signaloid/C0-microSD-Hardware/rtl-examples/breathe-button/README.md

# Breathing example
This design alternatively pulses the red and green LEDs in a "breathing" motion. The design also supports changing the breathing speed using two pushbuttons connected as the diagram below shows:

### Build and flash the `breathe-button` design:
- Make sure that the open-source CAD toolchain is properly installed.
- Run `make`. 
- After the example builds successfully, insert the Signaloid C0-microSD into your computer.
- Verify the device path at which the Signaloid C0-microSD device shows up in your operating system. In our example, the Signaloid C0-microSD device path is `/dev/disk4`.
- Verify that the device is in `Bootloader` mode (solid red LED).
  - In case the device is not in `Bootloader` mode, you can switch its operation mode by running `make make flash DEVICE=<device-path>` and power-cycling the device.
- Run `make flash DEVICE=<device-path>`. Make sure to replace the `<device-path>` with the correct path of the C0-microSD. For example, if the device path is `/dev/disk4`, you will need to run `make flash DEVICE=/dev/disk4`.

Refer to the [documentation](https://c0-microsd-docs.signaloid.io/guides/identify-c0-microsd.html) to find the device path for the C0-microSD connected to your computer.

If the bitstream flashed successfully, you should see:
```console
sudo python3 ../../submodules/C0-microSD-utilities/C0_microSD_toolkit.py -t /dev/disk4 -b top.bin
Signaloid C0-microSD | Loaded configuration: Bootloader | Version: 1.0 | State IDLE
Filename:  top.bin
File size:  104090 bytes.
Flashing custom user bitstream...
Attempt 1 of 5: Flashing... Verifying...
Success: The data matches.
Done.
```

MicroSD to SD card adapters often have a small switch on the side, check that the switch is in the position that allows writing to the C0-microSD.
If the switch is not in the correct position, you will encounter a permission error when attempting to flash the bitstream. 

You can now unplug the C0-microSD from your computer and power it up using a microSD breakout board. After 3 seconds, you should see the red and green LEDs breathing alternatively.

### Schematic
```
                 VCC                         
┌────────────┐  ──┬──                        
│C0-microSD  │    │                          
│            │    │                          
│         3v3│────┘                          
│         GND├───────┐                       
│     SD_DAT2│───────┼───────────┐           
│     SD_DAT3├───────┼───────────┼───────┐   
└────────────┘       │           │       │   
                     │            /       /  
                   ──┴──         /       /   
                    GND          │       │   
                               ──┴──   ──┴── 
                                GND     GND  
```

### Breadboard configuration example
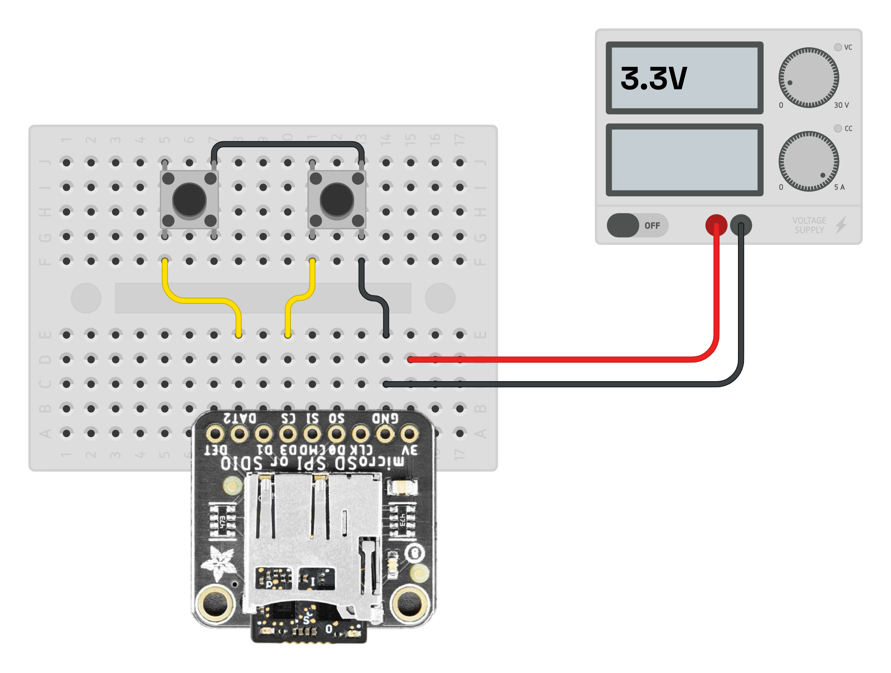
[picture p1: rtl-examples/breathe-button/images/breathe-button-breadboard.png]
Breathe button breadboard schematic


If the bitstream flashed successfully, you should see:
```console
sudo python3 ../../submodules/C0-microSD-utilities/C0_microSD_toolkit.py -t /dev/disk4 -b top.bin
Signaloid C0-microSD | Loaded configuration: Bootloader | Version: 1.0 | State IDLE
Filename:  top.bin
File size:  104090 bytes.
Flashing custom user bitstream...
Attempt 1 of 5: Flashing... Verifying...
Success: The data matches.
Done.
```

You can now unplug the C0-microSD from your computer and power it up using a microSD breakout board. After 3 seconds, you should see the red and green LEDs blinking alternatively.
