signaloid/C0-microSD-Hardware/c0-microsd-quickstart.pdf

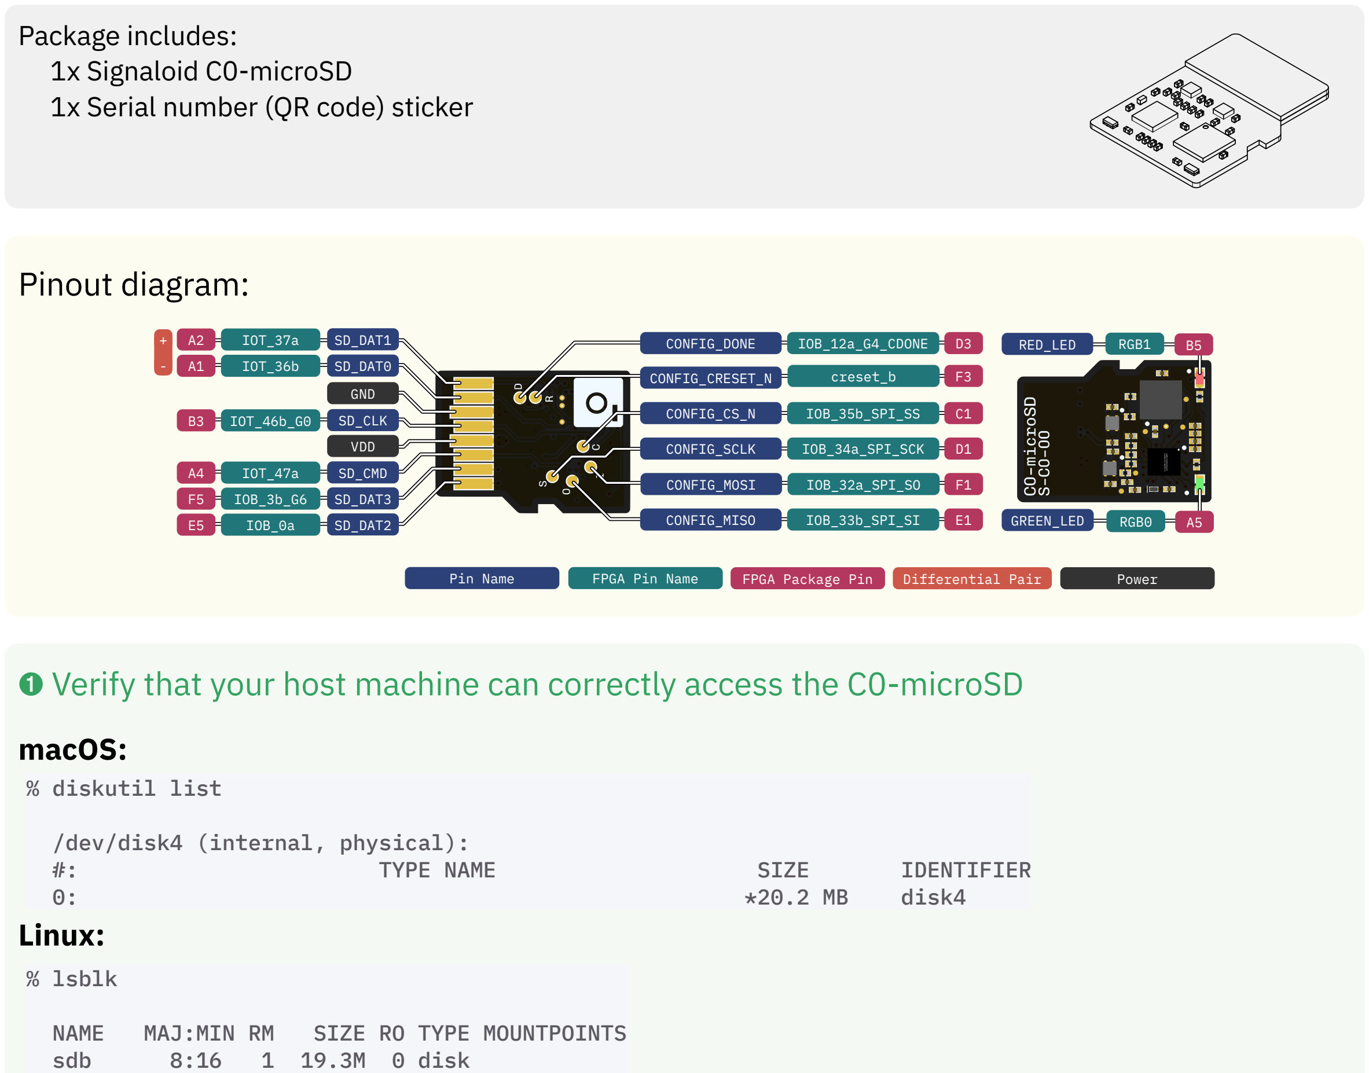
[picture p8: figure]
% diskutil list; /dev/disk4 (internal, physical):; TYPE NAME; SIZE; IDENTIFIER; disk4; % lsblk; sdb; 1 19.3M 0 disk; macOS:; Linux:; Package includes: 1x Signaloid C0-microSD 1x Serial number (QR code) sticker; CONFIG_DONE; CONFIG_CRESET_N; CONFIG_MOSI; CONFIG_SCLK; CONFIG_CS_N; CONFIG_MISO; VDD; GND; SD_CMD SD_DAT3 SD_DAT2; SD_CLK; SD_DAT0; SD_DAT1; RED_LED; GREEN_LED; IOB_12a_G4_CDONE; IOB_32a_SPI_SO; IOB_34a_SPI_SCK; IOB_35b_SPI_SS; IOB_33b_SPI_SI; IOT_47a IOB_3b_G6 IOB_0a; IOT_46b_G0; IOT_36b; IOT_37a; creset_b; RGB1; RGB0; Pin Name; FPGA Pin Name; FPGA Package Pin; Differential Pair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

# ➊ Verify that your host machine can correctly access the C0-microSD

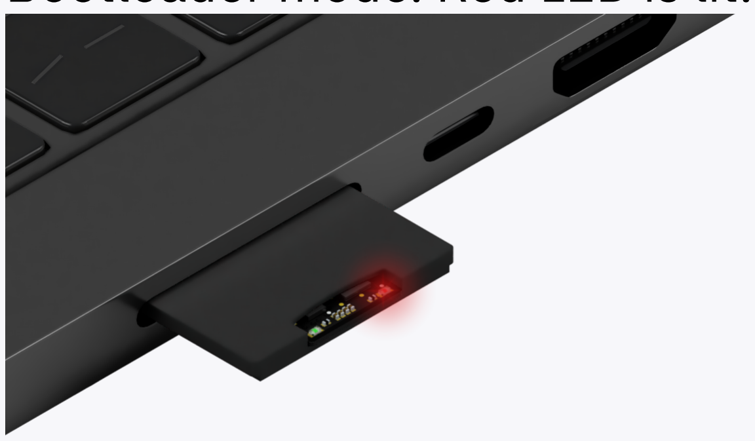
[picture p9: figure]

➌ Run an example.

NAME | MAJ:MIN RM | SIZE RO TYPE MOUNTPOINTS

# ➋ Check which mode the C0-microSD is in (default is “bootloader mode”)

Bootloader mode. Red LED is lit. | SoC mode. Green LED is lit.

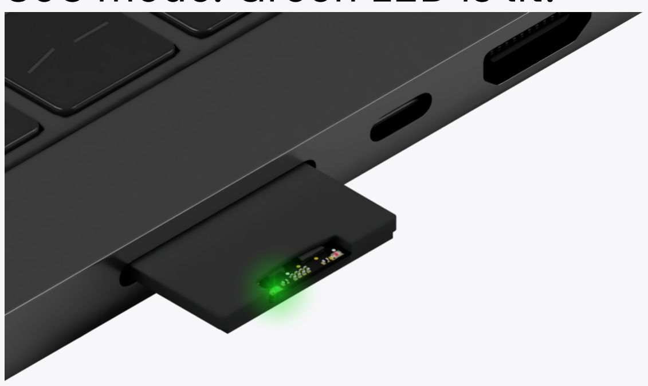
[picture p10: figure]

# In bootloader mode, you can load custom FPGA bitstreams to the

C0-microSD. See link for hardware RTL examples.

# In SoC mode, you can load programs to the Signaloid RISC-V SoC and

interact with these programs over the SD interface. See links for examples.

# Signaloid C0-microSD QuickStart Guide

Copyright © 2025 Signaloid.
