signaloid/C0-microSD-Hardware/docs/hardware-overview/compatibility.md

---
layout: default
parent: "Hardware Overview"
title: "Compatibility"
nav_order: 6
---

# Device compatibility

We designed the Signaloid C0-microSD to emulate a version 1.0 SD card. We have tested the compatibility with the following host devices:

| Host device | Product Page | Mechanical | SD Interface |
| :--- | :---: | :---: | :---: |
| Macbook Pro M1 | [apple.com](https://support.apple.com/en-us/111902) | Yes | Yes |
| SD-Dev | [crowdsupply.com](https://www.crowdsupply.com/signaloid/signaloid-c0-microsd) | Yes | Yes |
| Kingston MobileLite Plus | [kingston.com](https://www.kingston.com/en/memory-card-readers/mobilelite-plus-sd-reader) | Yes | Yes |
| Hoco HB20 | [hocotech.com](https://hocotech.com/product/mobile-accessories/cables/adapters/card-reader-hb20-mindful-2-in-1-usb2-0-usb3-0/) | Yes | Yes |
| Hama "8in1" Transparent | [hama.com](https://ae.hama.com/00091092/hama-8in1-usb-2-0-card-reader-sd-microsd-transparent) | Yes | Yes |
| Ugreen USB C 7in1 Hub | [ugreen.com](https://eu.ugreen.com/products/ugreen-usb-c-7-in-1-hub-with-4k-60hz-hdmi?variant=46973588078940) | Yes | Yes |
| UGREEN Micro SD Card Reader | [ugreen.com](https://eu.ugreen.com/products/50706?_pos=5&_sid=f76931dfa&_ss=r) | Yes | Yes |
| CrowdSupply microSD Card Reader | [crowdsupply.com](https://www.crowdsupply.com/crowd-supply/basics) | Yes | Yes |
| Sandisk Pro Reader | [sandisk.com](https://shop.sandisk.com/products/accessories/memory-card-readers/sandisk-professional-pro-reader-sd-microsd?sku=SDPR5A8-0000-GBAND) | Yes | Yes |
| Delock CFadapter | [delock.com](https://www.delock.com/produkt/62542/merkmale.html) | Yes | Yes |

We have also tested the compatibility of the Signaloid C0-microSD with multiple existing embedded platforms that support microSD cards:

| Host device | Product Page | Mechanical | SD Interface |
| :--- | :---: | :---: | :---: |
| Bosch ctrlX core X3 PLC | [boschrexroth.com](https://apps.boschrexroth.com/microsites/ctrlx-automation/en/portfolio/ctrlx-core/) | Yes | Yes |
| Wago PFC100 PLC |  [wago.com](https://www.wago.com/global/plcs-%E2%80%93-controllers/compact-controller-100/p/751-9301)  | Yes | Yes |
| Wago PFC200 PLC | [wago.com](https://www.wago.com/global/automation-technology/discover-plcs/pfc200) | Yes | Untested |
| Phoenix Contact PLCNEXT PLC | [phoenixcontact.com](https://www.phoenixcontact.com/en-us/us-lp-open) | Yes | Untested |
| SparkFun MicroMod AssetTracker | [sparkfun.com](https://www.sparkfun.com/products/17272) | Yes | Untested |
| SparkFun MicroMod-MachineLearning Carrier Board | [sparkfun.com](https://www.sparkfun.com/products/16400) | Yes | Untested |
| SparkFun DataLogger IoT | [sparkfun.com](https://www.sparkfun.com/products/20594) | Yes | Untested |
| SparkFun QWIIC OpenLog | [sparkfun.com](https://www.sparkfun.com/products/15164) | Yes | Untested |
| SparkFun ThingPlus RP2040 | [sparkfun.com](https://www.sparkfun.com/products/17745) | Yes | Untested |
| SparkFun ThingPlus STM32 | [sparkfun.com](https://www.sparkfun.com/products/17712) | Yes | Yes |
| SparkFun OpenLog Artemis | [sparkfun.com](https://www.sparkfun.com/products/16832) | Yes | Untested |
| Adafruit Feather Adalogger | [adafruit.com](https://www.adafruit.com/product/2796) | Yes | Untested |
| Adafruit Feather M0 Adalogger | [adafruit.com](https://www.adafruit.com/product/2796) | Yes | Untested |
| Beaglebone AI | [beagleboard.org](https://www.beagleboard.org/boards/beaglebone-ai) | Yes | Untested |
| M5Stack Cardputer | [m5stack.com](https://shop.m5stack.com/products/m5stack-cardputer-kit-w-m5stamps3) | Yes | Yes |
