signaloid/C0-microSD-Hardware/docs/assets/images/C0-microSD-front-back.jpeg

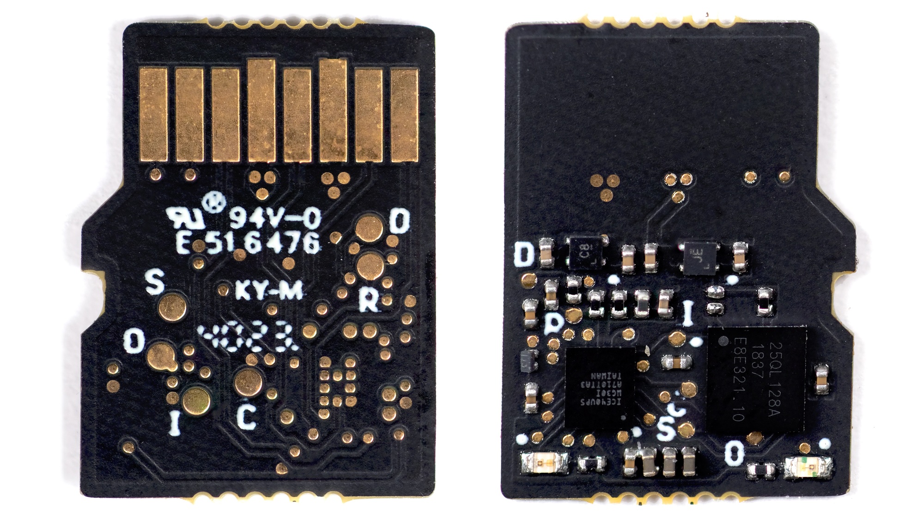
docs/assets/images/C0-microSD-front-back.jpeg
