signaloid/C0-microSD-Hardware/docs/assets/images/C0-microSD-pinout-horizontal.png

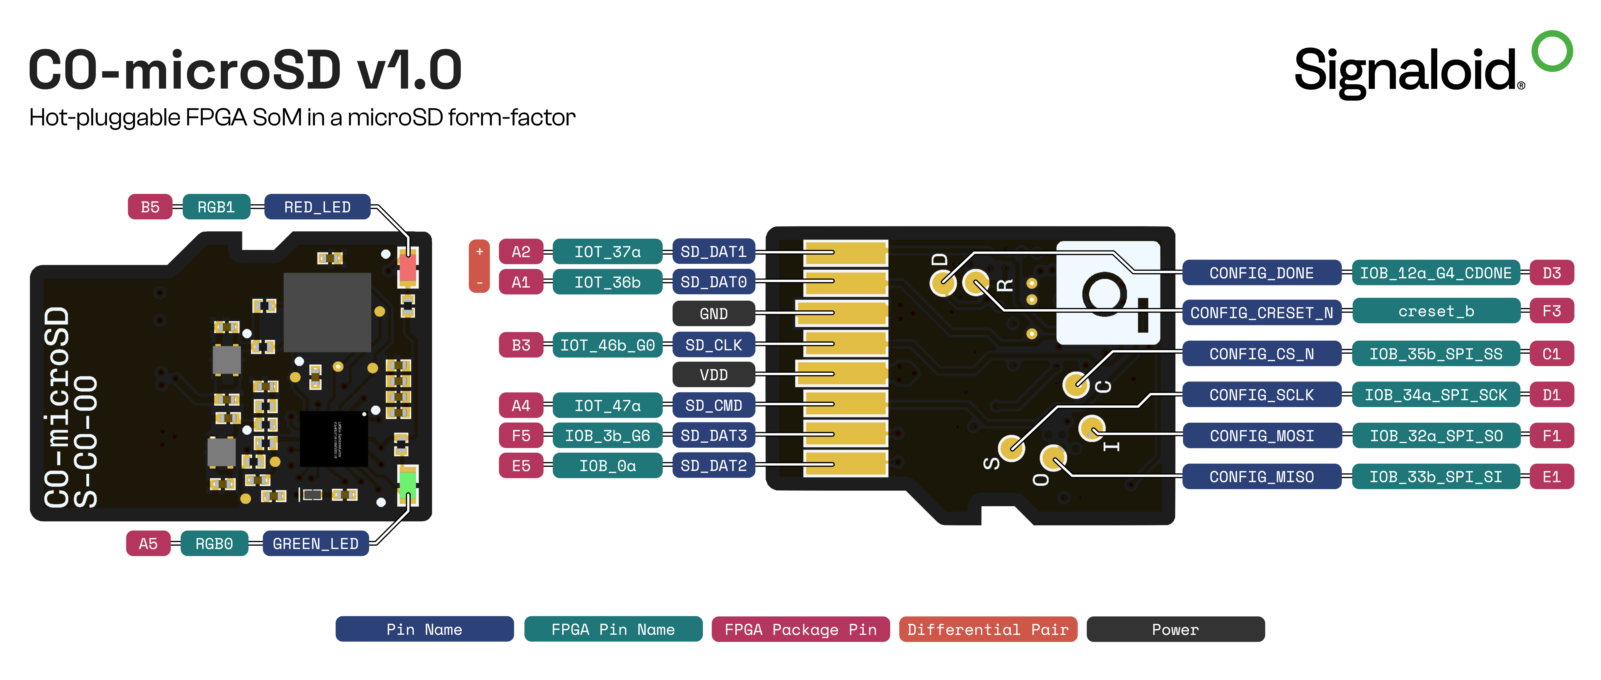
docs/assets/images/C0-microSD-pinout-horizontal.png
