signaloid/C0-microSD-Hardware/docs/assets/images/C0-microSD-pinout.png

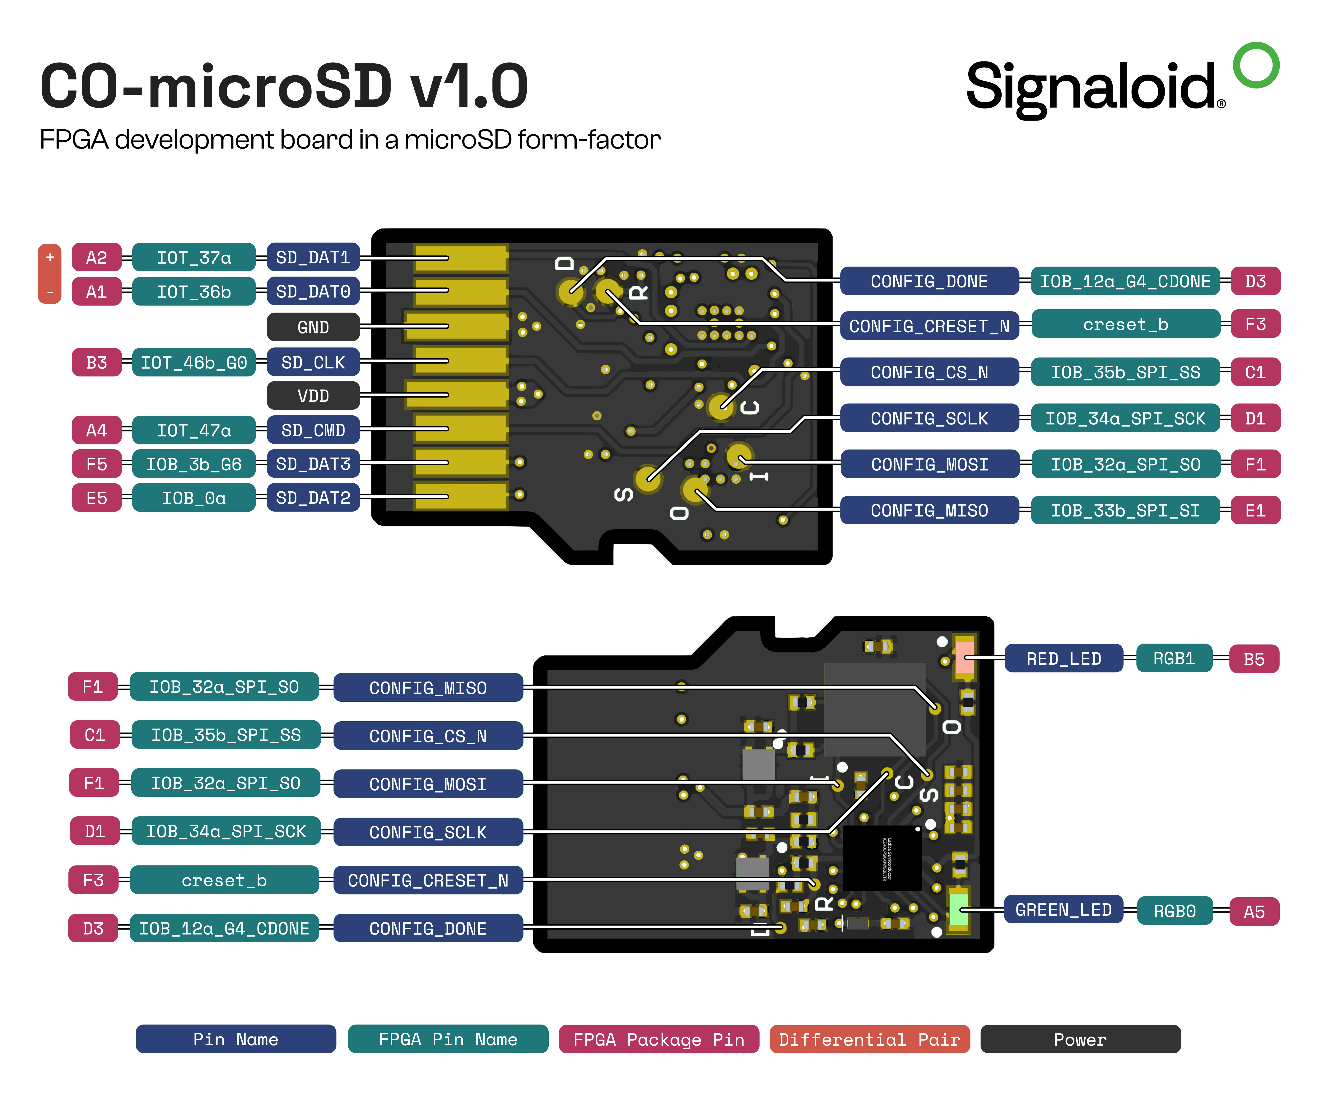
docs/assets/images/C0-microSD-pinout.png
