signaloid/C0-microSD-Hardware/docs/assets/images/diagrams/bootloader-logic-diagram.png

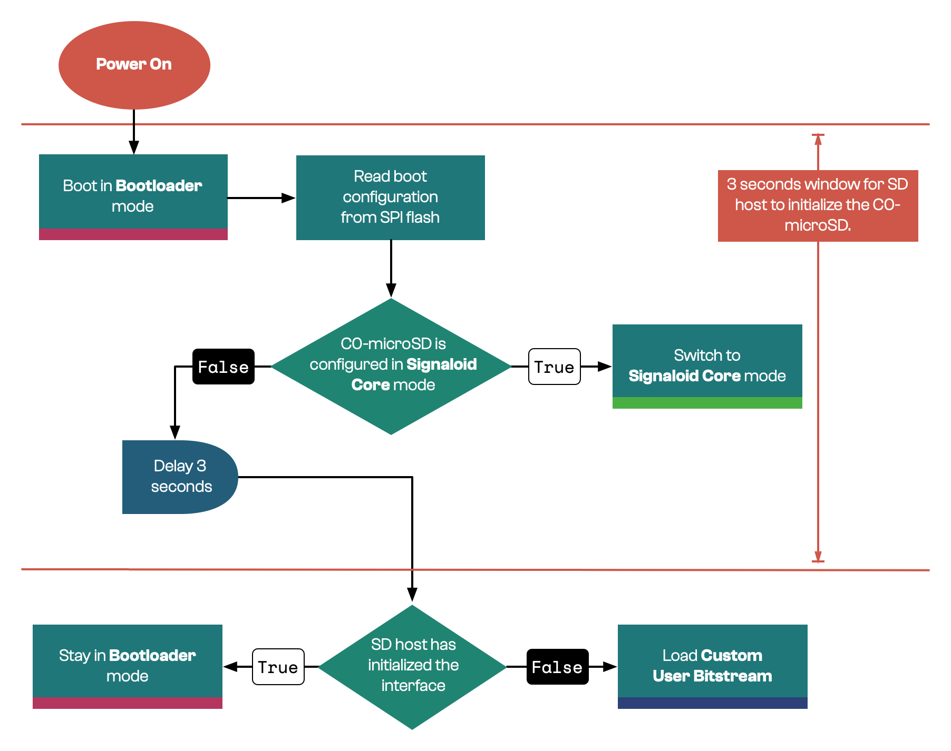
docs/assets/images/diagrams/bootloader-logic-diagram.png
