signaloid/C0-microSD-Hardware/docs/assets/images/diagrams/C0-microSD-memory-map.png

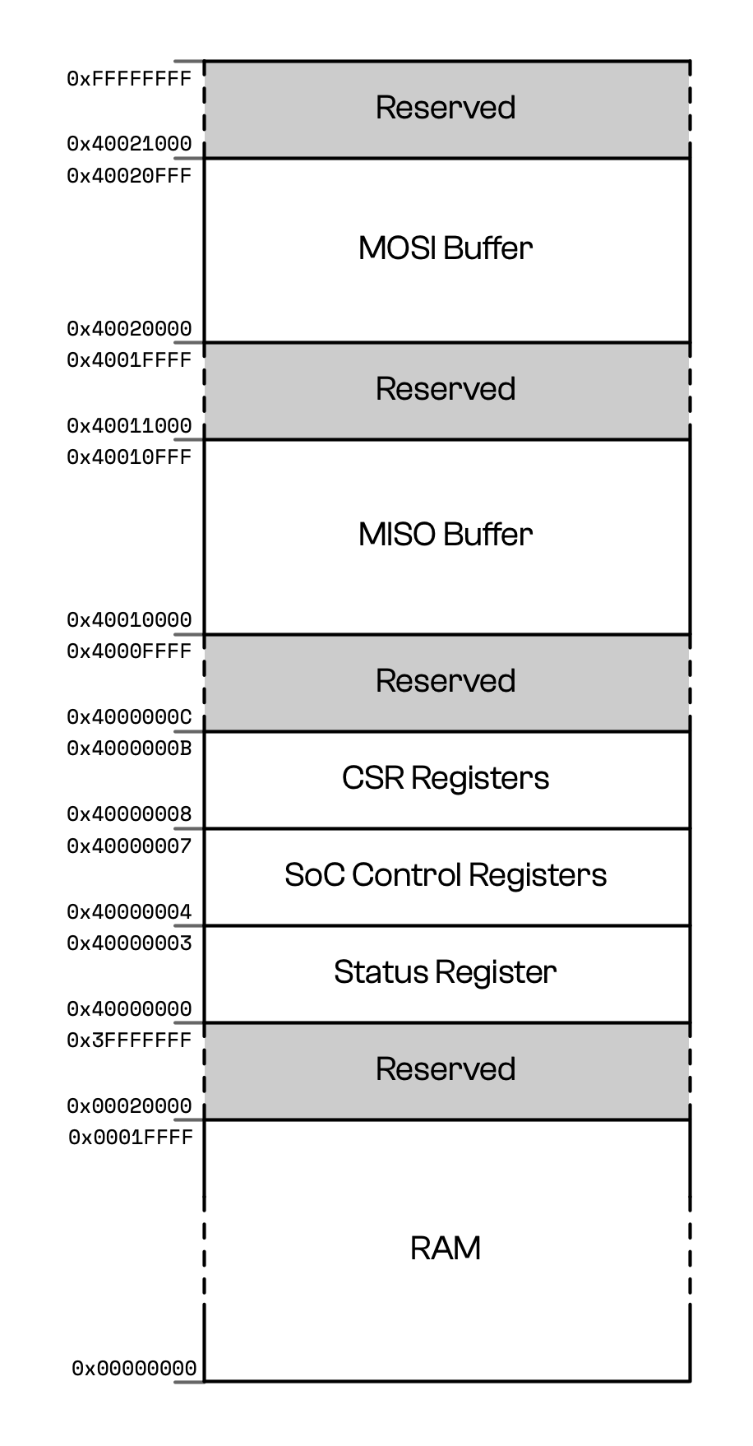
docs/assets/images/diagrams/C0-microSD-memory-map.png
