signaloid/C0-microSD-Hardware/docs/assets/images/diagrams/C0-uSD-tigard-connection.png

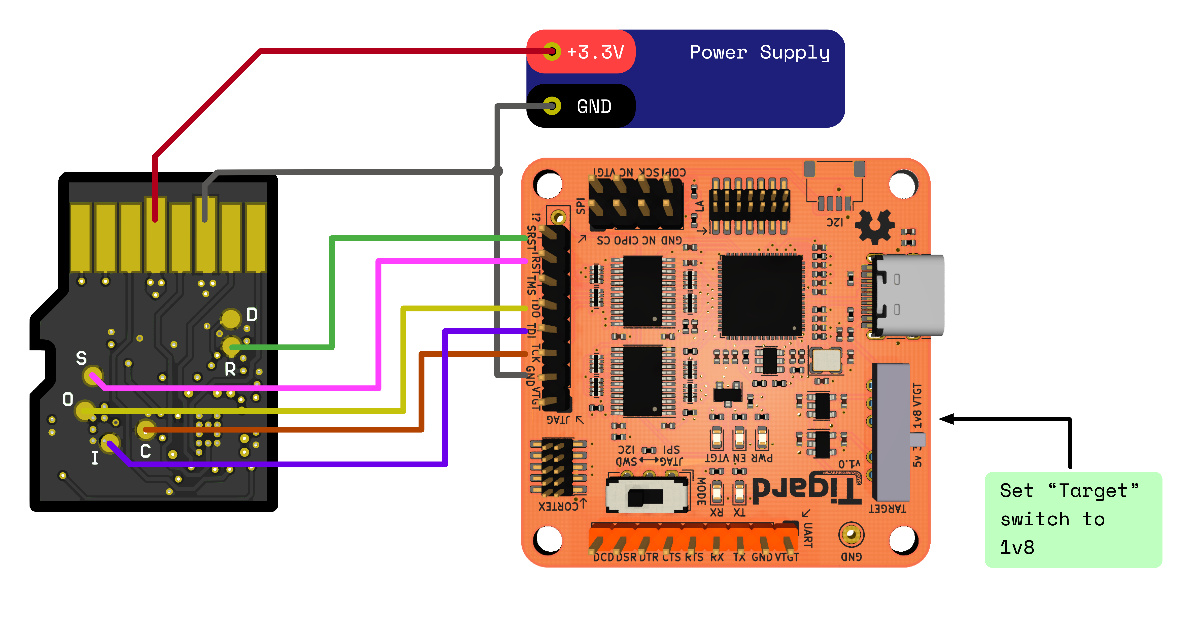
docs/assets/images/diagrams/C0-uSD-tigard-connection.png
