signaloid/C0-microSD-Hardware/docs/assets/images/mac-popup.png

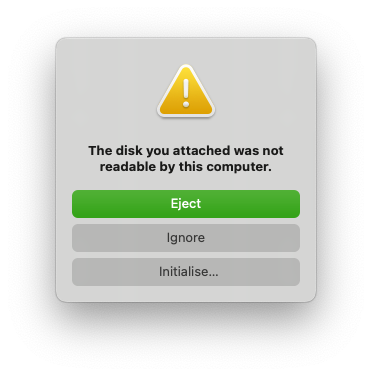
docs/assets/images/mac-popup.png
