signaloid/C0-microSD-Hardware/docs/assets/images/macbook-animations/insert.gif

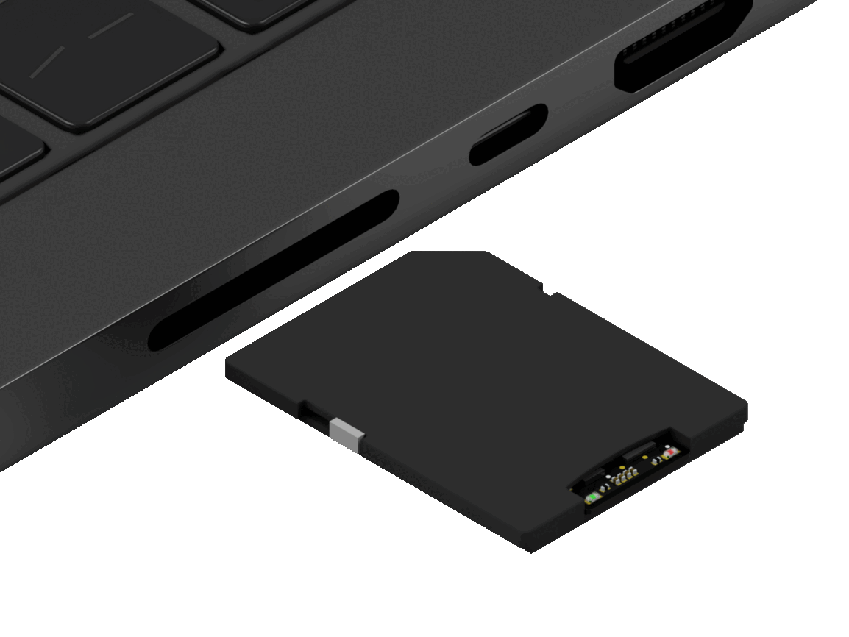
docs/assets/images/macbook-animations/insert.gif
