signaloid/C0-microSD-Hardware/docs/assets/images/ortho-renders/breakout-board/breakout-board.png

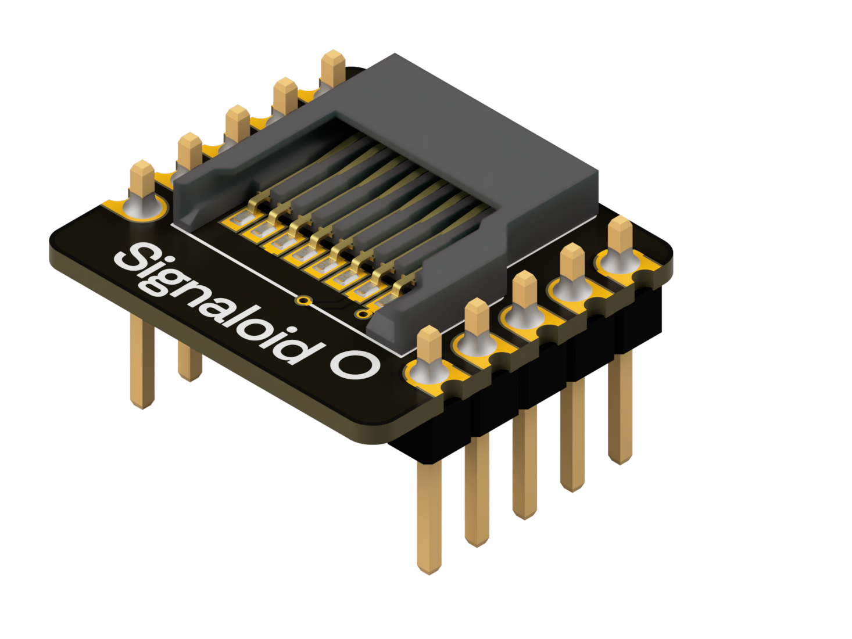
docs/assets/images/ortho-renders/breakout-board/breakout-board.png
