signaloid/C0-microSD-Hardware/docs/assets/images/ortho-renders/C0-microSD-signaloid-core/C0-microSD-with-signaloid-core-green-led.png

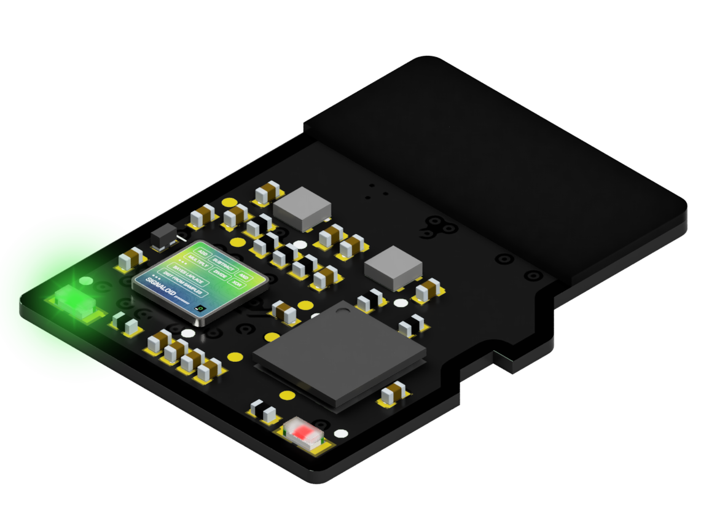
docs/assets/images/ortho-renders/C0-microSD-signaloid-core/C0-microSD-with-signaloid-core-green-led.png
