signaloid/C0-microSD-Hardware/docs/assets/images/ortho-renders/normal_size/C0-uSD-ortho-render-bot.png

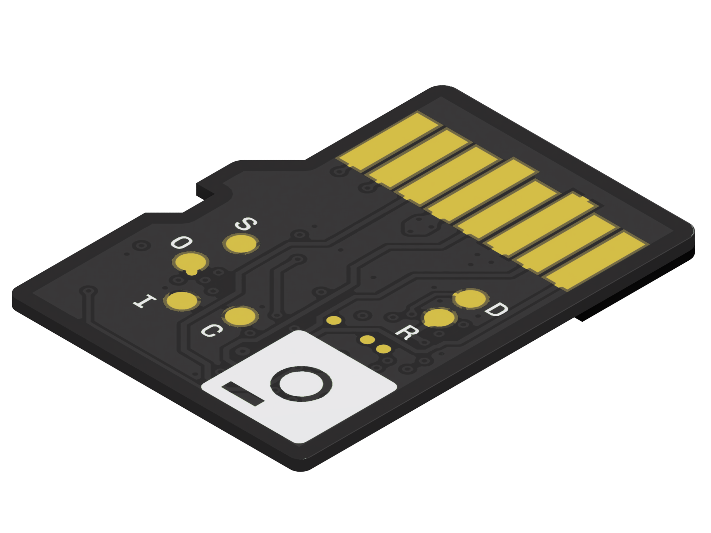
docs/assets/images/ortho-renders/normal_size/C0-uSD-ortho-render-bot.png
