signaloid/C0-microSD-Hardware/docs/assets/images/sd-dev-pinout.jpg

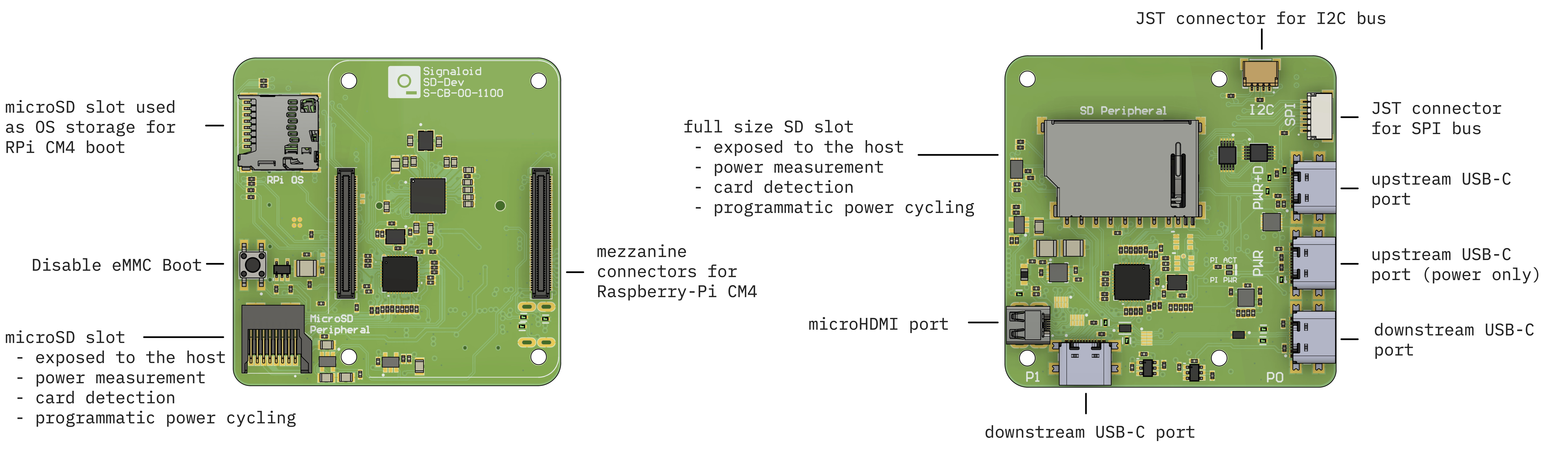
docs/assets/images/sd-dev-pinout.jpg
