signaloid/C0-microSD-Hardware/docs/assets/images/signaloid-module-scale-01.jpeg

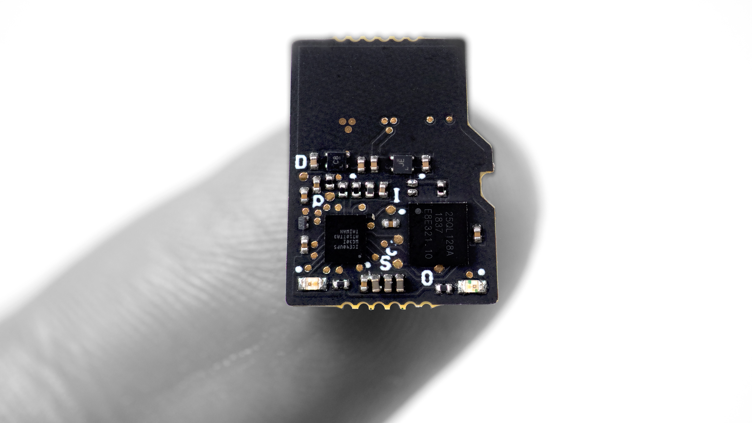
docs/assets/images/signaloid-module-scale-01.jpeg
