signaloid/C0-microSD-Hardware/docs/assets/images/subsea-integration.png

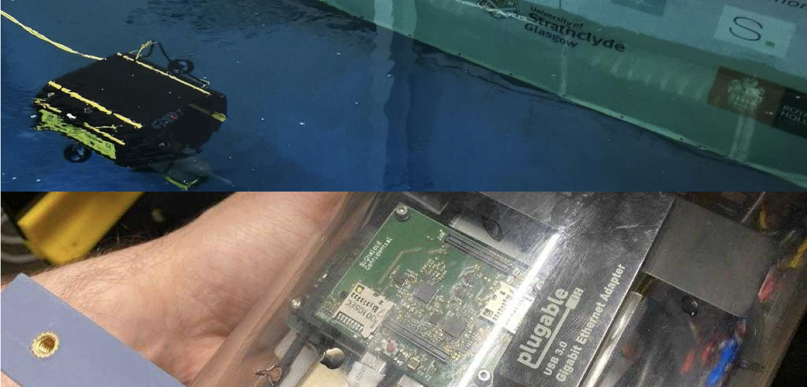
docs/assets/images/subsea-integration.png
