signaloid/C0-microSD-Hardware/images/C0-microSD-block-diagram.png

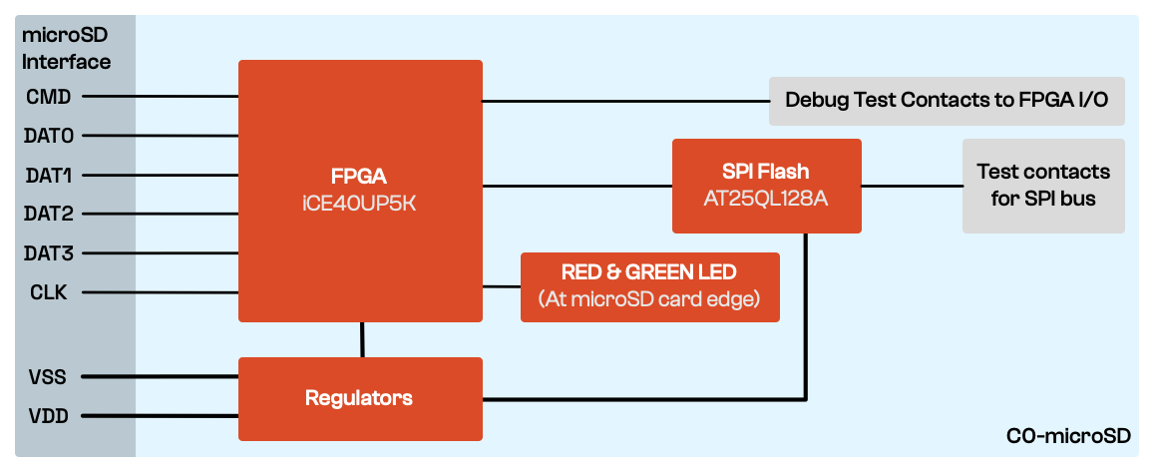
images/C0-microSD-block-diagram.png
