signaloid/C0-microSD-Hardware/rtl-examples/blink/images/mac-popup.png

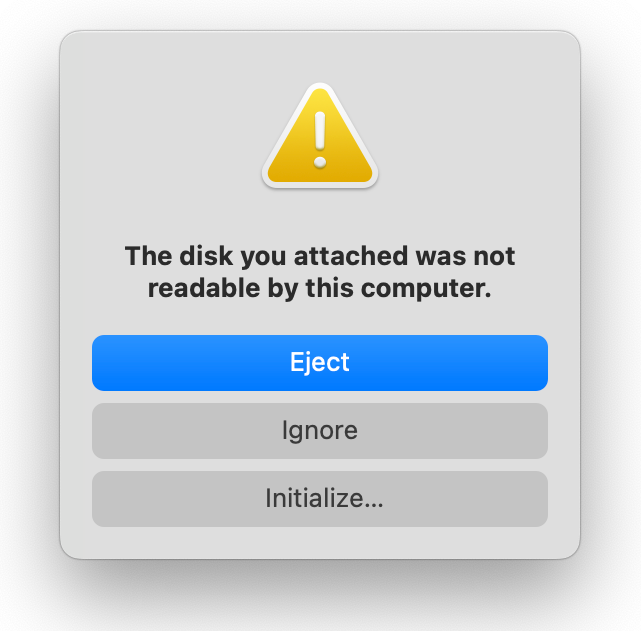
rtl-examples/blink/images/mac-popup.png
