signaloid/C0-microSD-Hardware/docs/guides/index.md

---
layout: default
title: "Guides"
has_children: true
nav_order: 3
---

# C0-microSD Guides
In this section of the documentation you can find a series of guides for working with your C0-microSD.
