signaloid/C0-microSD-Hardware/hardware/schematic.pdf

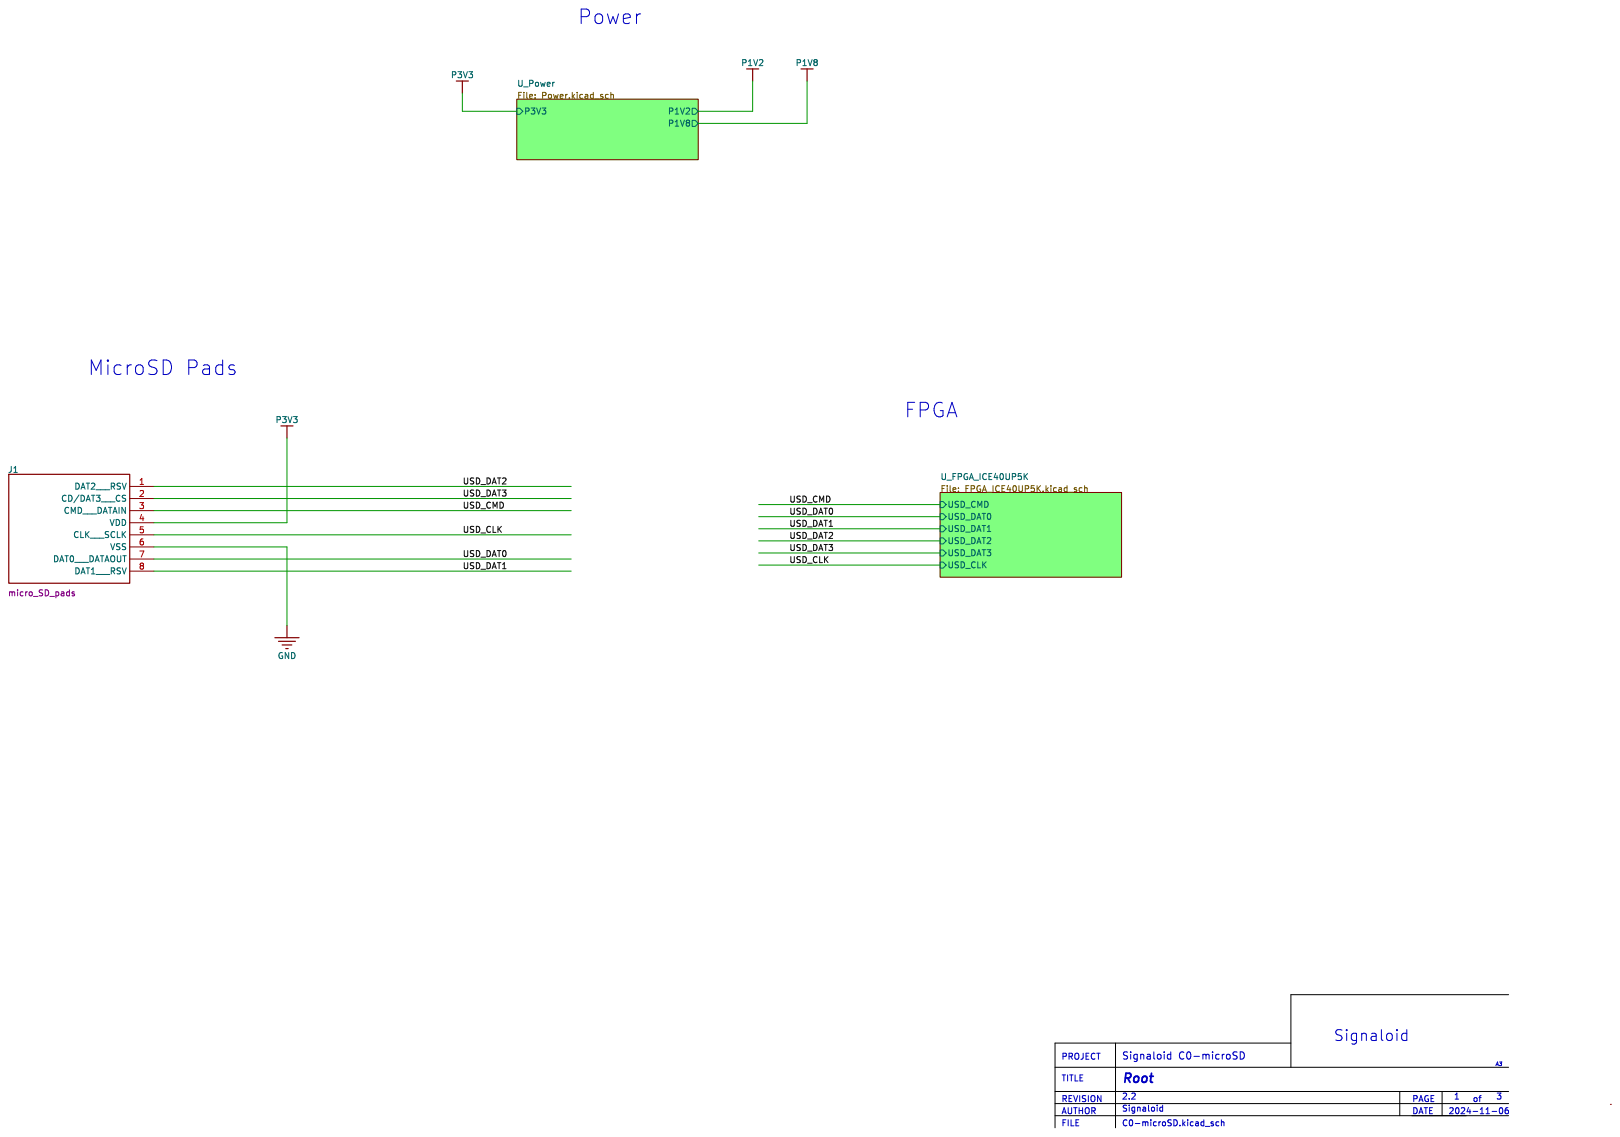
[picture p37: page 1]

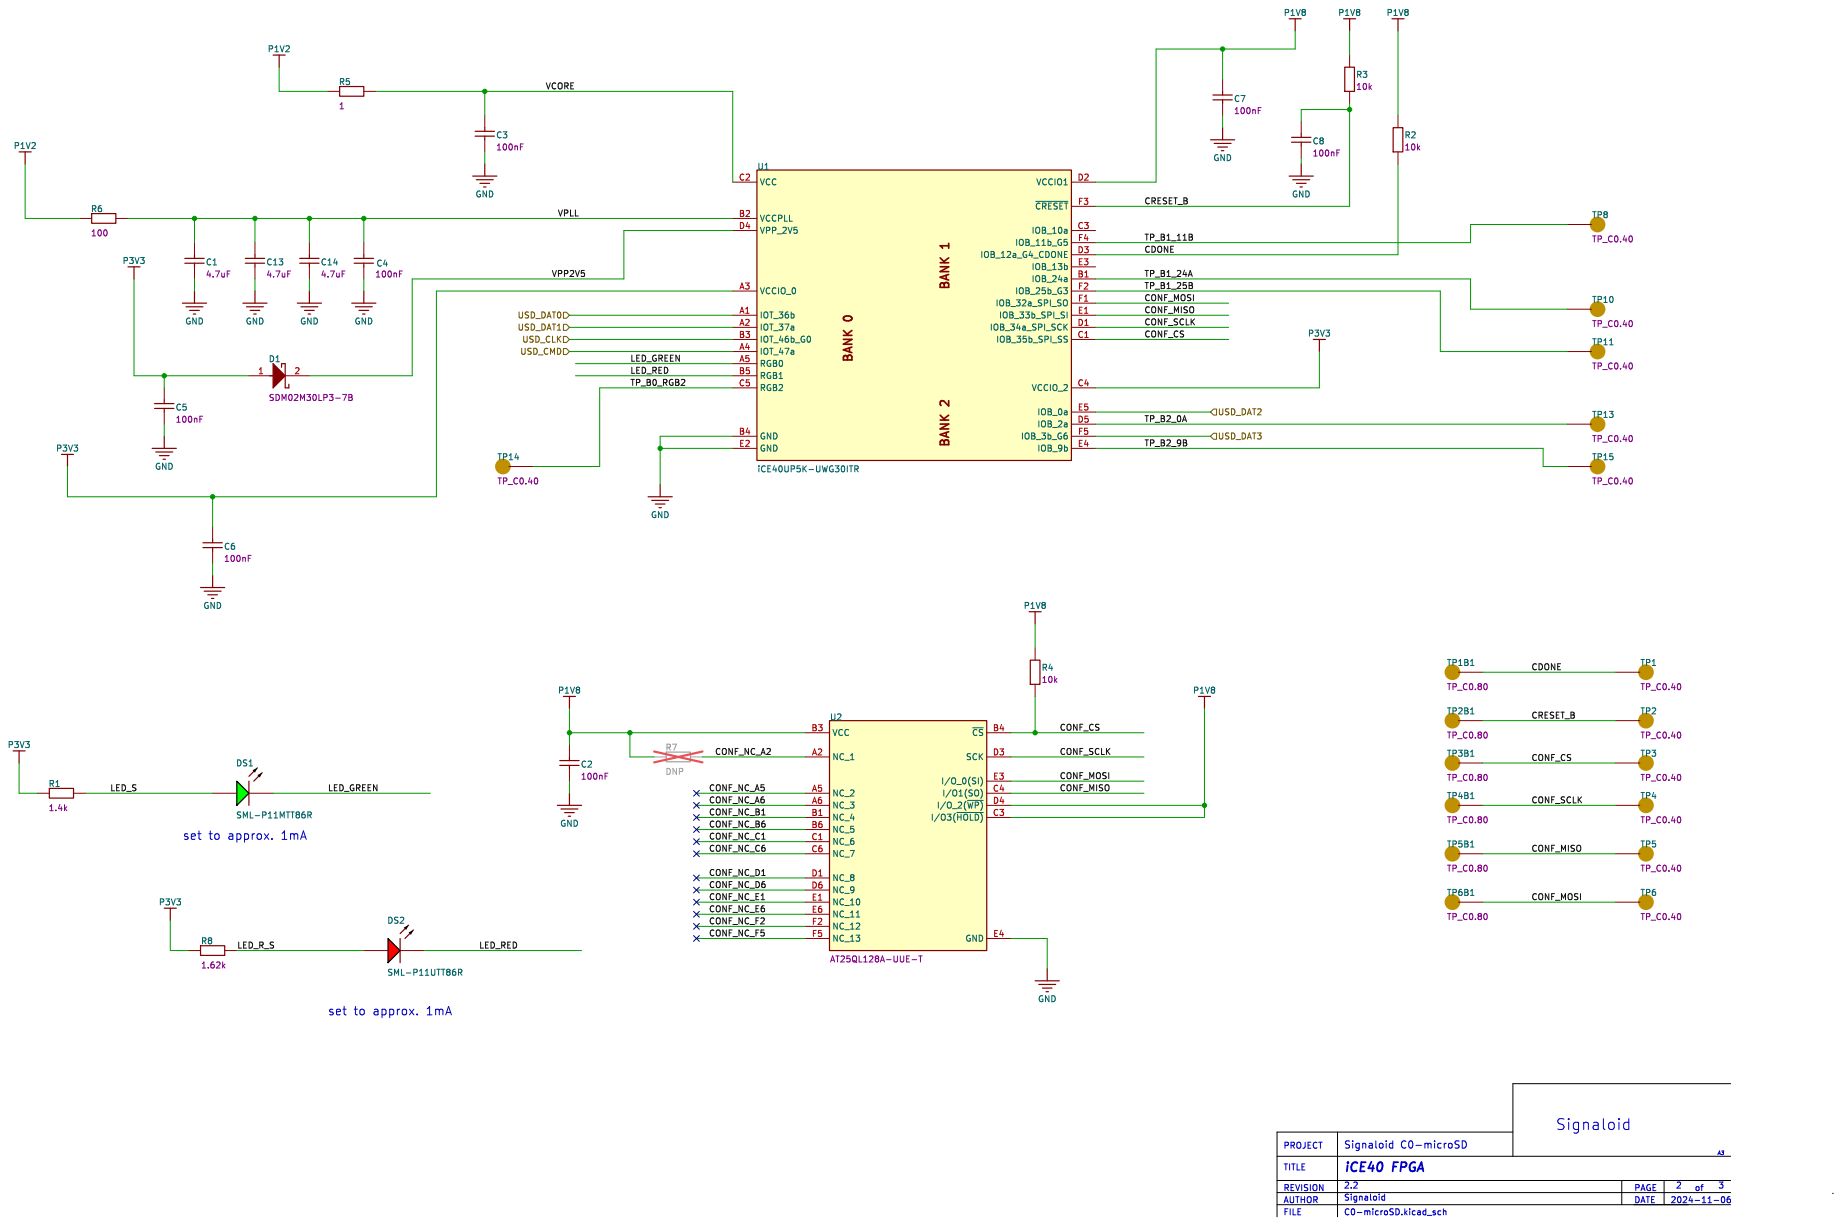
[picture p38: page 2]

FILE set to approx. 1mA

of set to approx. 1mA

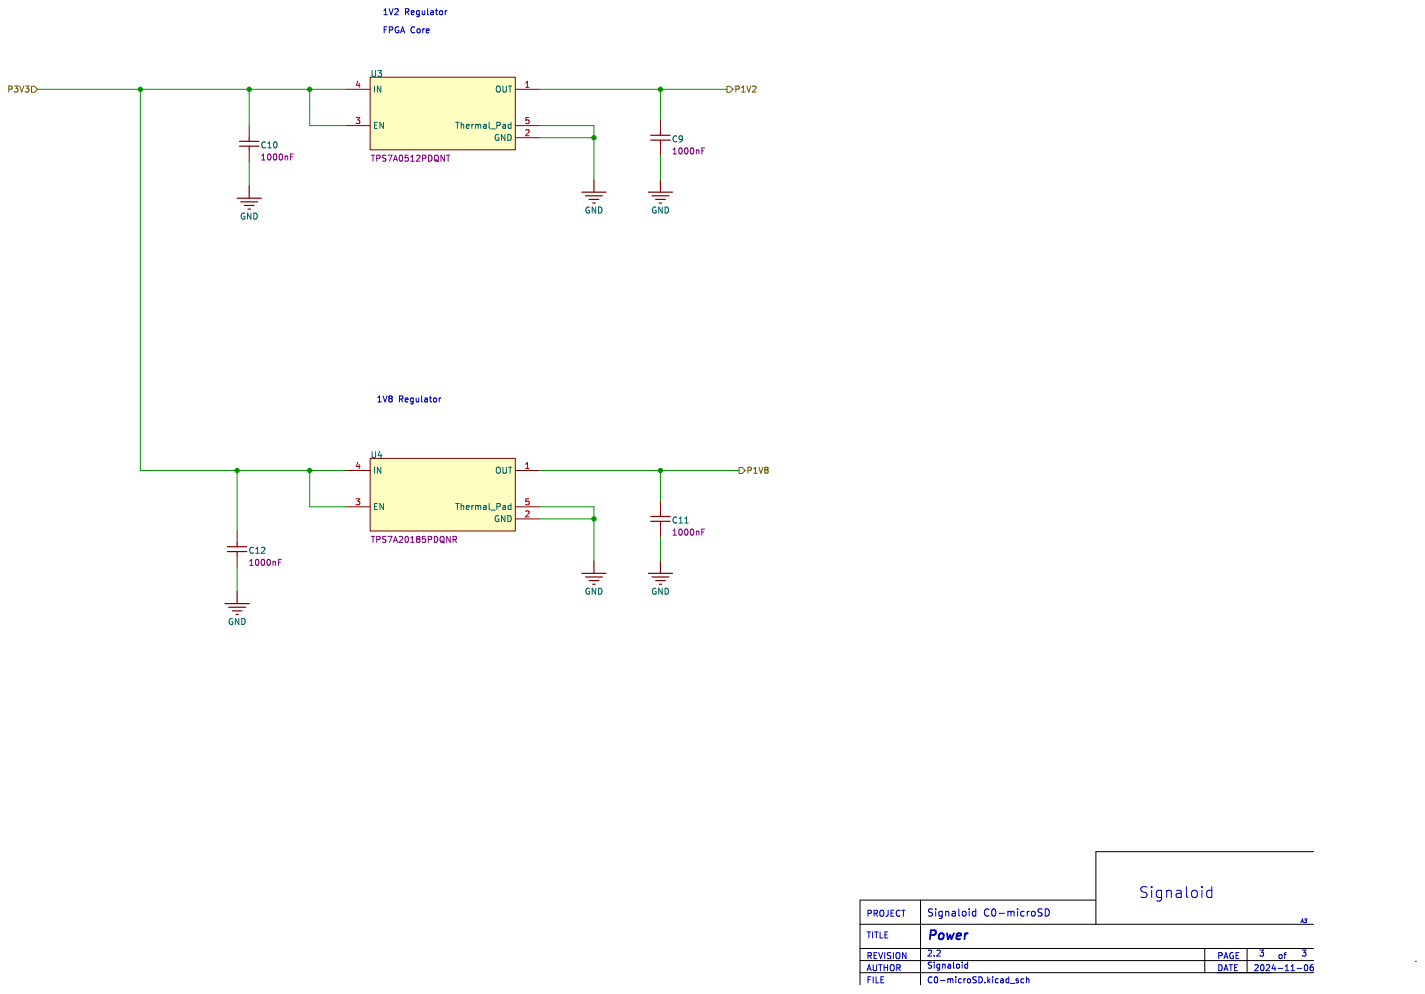
[picture p39: page 3]
