signaloid/C0-microSD-Hardware/docs/assets/images/diagrams/bootloader-logic-diagram.pdf

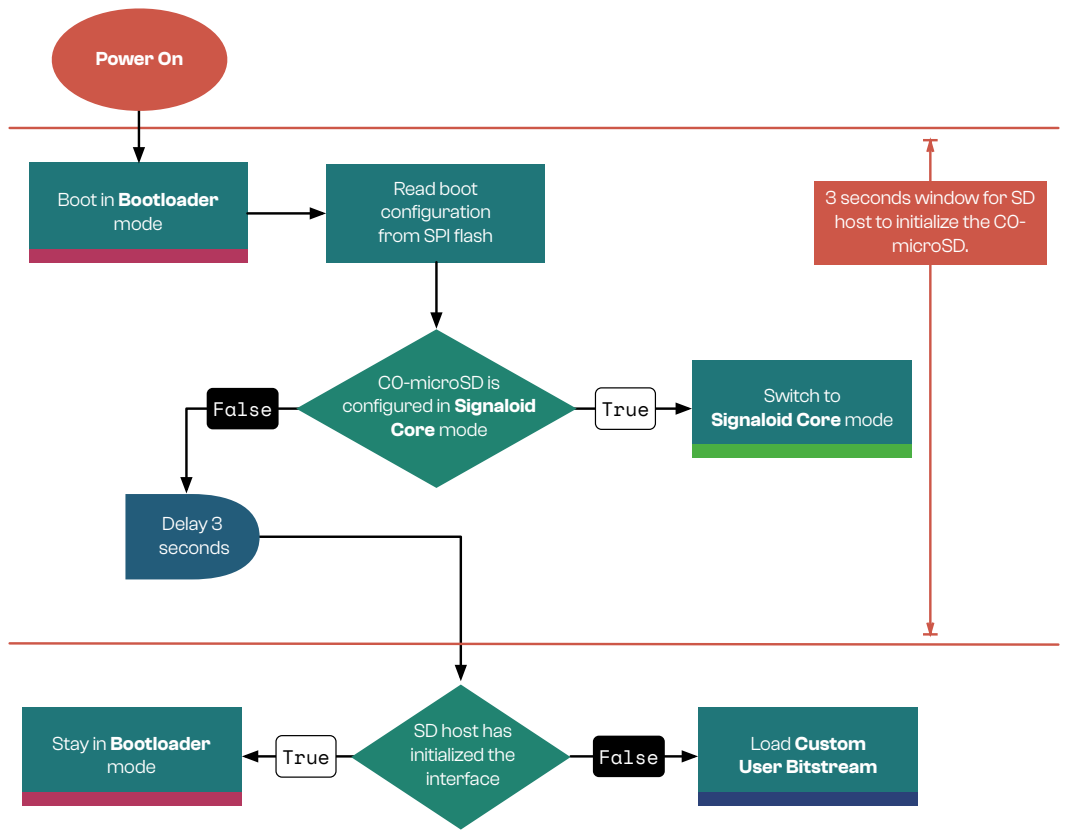
[picture p40: page 1]
Load Custom User Bitstream; False; Power On; True; Delay 3 seconds

Read boot
configuration
from SPI flash

Boot in Bootloader
mode

3 seconds window for SD
host to initialize the C0-
microSD.

C0-microSD is
configured in Signaloid
Core mode

Switch to
Signaloid Core mode

SD host has
initialized the
interface

Stay in Bootloader
