signaloid/C0-microSD-Hardware/(commit log)

2024-11-06 Upload device schematics
2025-09-17 Correct illustrations which are currently completely backwards
    bullets and captions are contradictory... 😩
2025-09-24 docs: added guides on how to use the SD-Dev with a Raspberry Pi compute module configured as a USB Serial and a USB Ethernet gadget
